sebseb7/brushless-controller/README.md

brushless-controller
====================
