sebseb7/brushless-controller/1bl.brd

## EAGLE design 1bl.brd (2013-03-14)

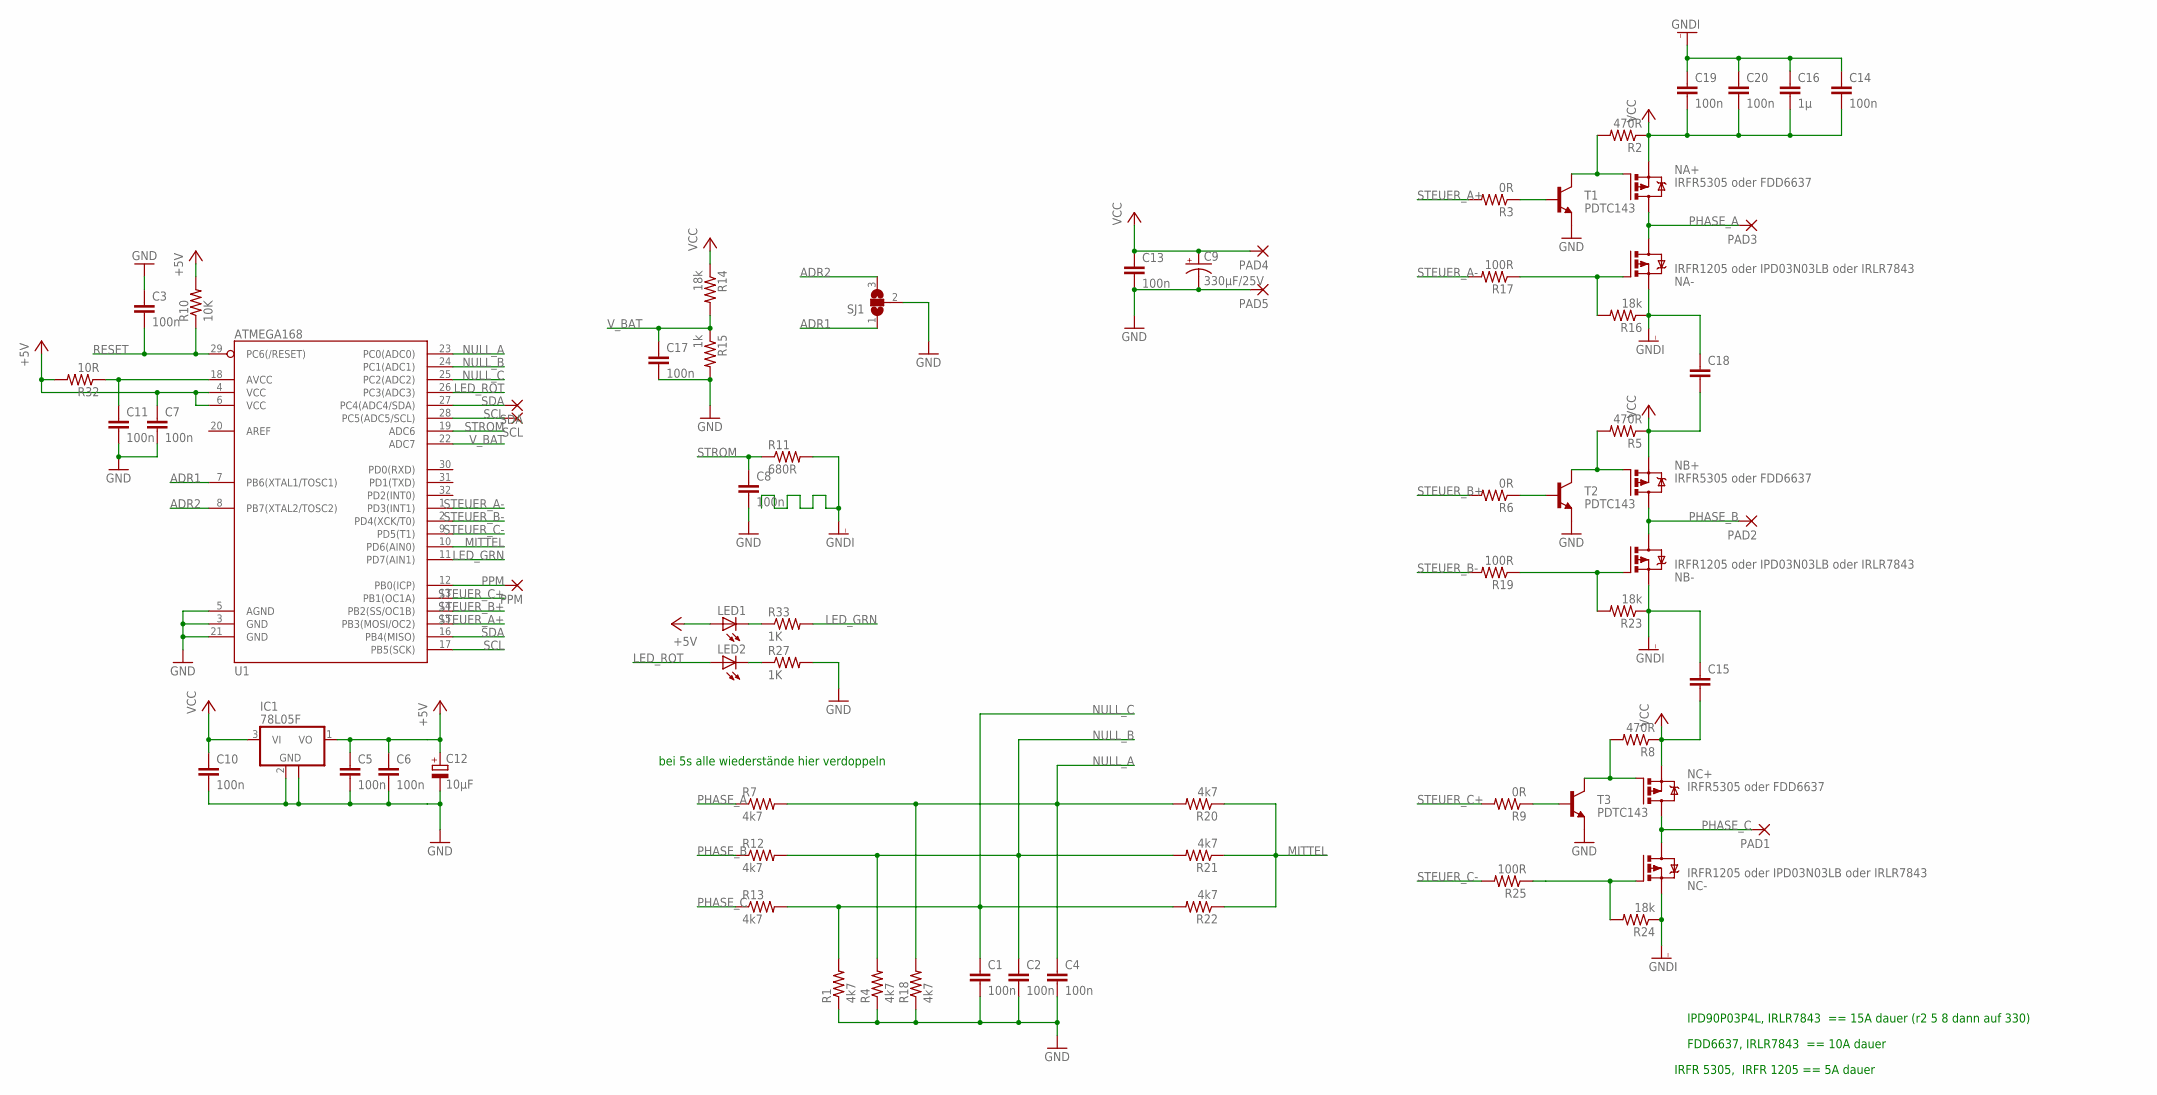
[picture p1: schematic 1bl.sch]

Parts:
C1, C2, C3, C4, C5, C6, C7, C8, C10, C11, C13, C14, C17, C19, C20: 100n; 0805
C9: 330µF/25V; CPOL-RADIAL-1000UF-25V
C12: 10µF; PANASONIC_B
C15, C18: CAP0805; 0805
C16: 1µ; 0805
IC1: 78L05F; SOT89
LED1, LED2: LEDCHIP-LED0805; CHIP-LED0805
NA+: IRFR5305 oder FDD6637; D-PAK_TO252AA
NA-: IRFR1205 oder IPD03N03LB oder IRLR7843; D-PAK_TO252AA
NB+: IRFR5305 oder FDD6637; D-PAK_TO252AA
NB-: IRFR1205 oder IPD03N03LB oder IRLR7843; D-PAK_TO252AA
NC+: IRFR5305 oder FDD6637; D-PAK_TO252AA
NC-: IRFR1205 oder IPD03N03LB oder IRLR7843; D-PAK_TO252AA
PAD1, PAD2, PAD3, PAD4, PAD5: SMD5; SMD2,54-5,08
PPM: SMD2; SMD1,27-2,54
R1, R4, R7, R12, R13, R18, R20, R21, R22: 4k7; 0805
R2, R5, R8: 470R; 0805
R3, R6, R9: 0R; 0805
R10: 10K; 0805
R11: 680R; 0805
R14, R16, R23, R24: 18k; 0805
R15: 1k; 0805
R17, R19, R25: 100R; 0805
R27, R33: 1K; 0805
R32: 10R; 0805
SCL: SMD2; SMD1,27-2,54
SDA: SMD2; SMD1,27-2,54
SJ1: SJ2W; SJ_2
T1, T2, T3: PDTC143; SOT23
U1: ATMEGA168; TQFP32-08

Connections:
+5V: C5.1, C6.1, C7.1, C12.+, IC1.1 (VO), LED1.A, R10.2, R32.2, U1.4 (VCC), U1.6 (VCC)
ADR1: SJ1.1, U1.7 (PB6(XTAL1/TOSC1))
ADR2: SJ1.3, U1.8 (PB7(XTAL2/TOSC2))
GND: C1.2, C2.2, C3.1, C4.2, C5.2, C6.2, C7.2, C8.2, C9.2 (-), C10.2, C11.2, C12.-, C13.2, C17.2, IC1.2 (GND), IC1.2@1 (GND), PAD5.1, R1.1, R4.1, R15.2, R18.1, R27.2, SJ1.2, T1.2 (E), T2.2 (E), T3.2 (E), U1.3 (GND), U1.5 (AGND), U1.21 (GND)
GNDI: C14.1, C15.1, C16.1, C18.1, C19.1, C20.1, NA-.3 (S), NB-.3 (S), NC-.3 (S), R11.2, R16.1, R23.1, R24.1
LED_GRN: R33.2, U1.11 (PD7(AIN1))
LED_ROT: LED2.A, U1.26 (PC3(ADC3))
MITTEL: R20.1, R21.1, R22.1, U1.10 (PD6(AIN0))
unnamed: C11.1, R32.1, U1.18 (AVCC)
unnamed: NC+.1 (G), R8.2, T3.3 (C)
unnamed: NB+.1 (G), R5.2, T2.3 (C)
unnamed: NA+.1 (G), R2.2, T1.3 (C)
unnamed: LED1.C, R33.1
unnamed: LED2.C, R27.1
unnamed: NA-.1 (G), R16.2, R17.1
unnamed: NB-.1 (G), R19.1, R23.2
unnamed: NC-.1 (G), R24.2, R25.1
unnamed: R3.1, T1.1 (B)
unnamed: R6.1, T2.1 (B)
unnamed: R9.1, T3.1 (B)
NULL_A: C4.1, R7.2, R18.2, R20.2, U1.23 (PC0(ADC0))
NULL_B: C2.1, R4.2, R12.2, R21.2, U1.24 (PC1(ADC1))
NULL_C: C1.1, R1.2, R13.2, R22.2, U1.25 (PC2(ADC2))
PHASE_A: NA+.4 (D), NA-.4 (D), PAD3.1, R7.1
PHASE_B: NB+.4 (D), NB-.4 (D), PAD2.1, R12.1
PHASE_C: NC+.4 (D), NC-.4 (D), PAD1.1, R13.1
PPM: PPM.1, U1.12 (PB0(ICP))
RESET: C3.2, R10.1, U1.29 (PC6(/RESET))
SCL: SCL.1, U1.17 (PB5(SCK)), U1.28 (PC5(ADC5/SCL))
SDA: SDA.1, U1.16 (PB4(MISO)), U1.27 (PC4(ADC4/SDA))
STEUER_A+: R3.2, U1.15 (PB3(MOSI/OC2))
STEUER_A-: R17.2, U1.1 (PD3(INT1))
STEUER_B+: R6.2, U1.14 (PB2(SS/OC1B))
STEUER_B-: R19.2, U1.2 (PD4(XCK/T0))
STEUER_C+: R9.2, U1.13 (PB1(OC1A))
STEUER_C-: R25.2, U1.9 (PD5(T1))
STROM: C8.1, R11.1, U1.19 (ADC6)
VCC: C9.1 (+), C10.1, C13.1, C14.2, C15.2, C16.2, C18.2, C19.2, C20.2, IC1.3 (VI), NA+.3 (S), NB+.3 (S), NC+.3 (S), PAD4.1, R2.1, R5.1, R8.1, R14.1
V_BAT: C17.1, R14.2, R15.1, U1.22 (ADC7)

Notes on the sheet:
FDD6637, IRLR7843 == 10A dauer
IRFR 5305, IRFR 1205 == 5A dauer
IPD90P03P4L, IRLR7843 == 15A dauer (r2 5 8 dann auf 330)
bei 5s alle wiederstände hier verdoppeln

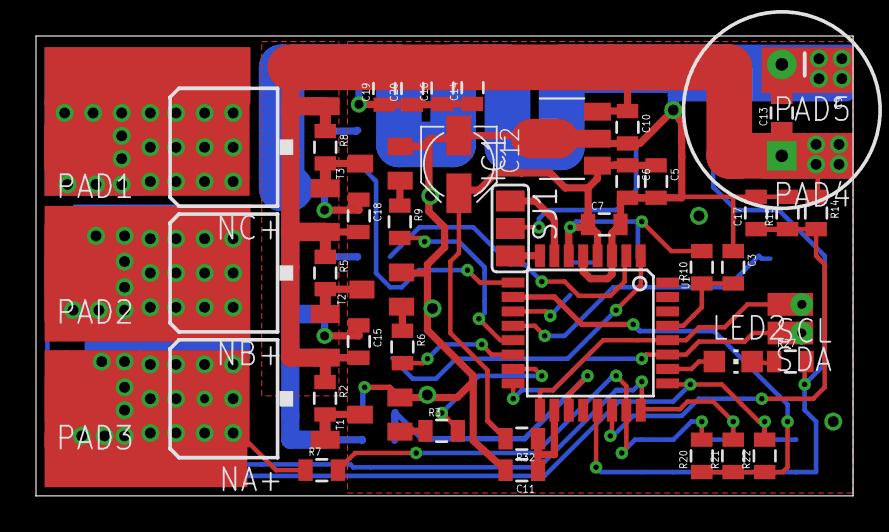
[picture p2: board 1bl.brd from above]

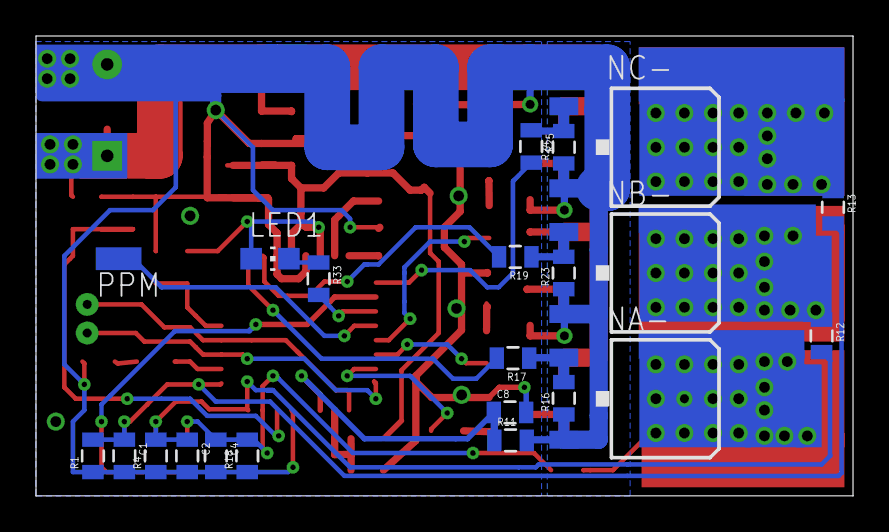
[picture p3: board 1bl.brd from below]

Board: 2 copper layers, 45.4 x 25.5 mm, 70 parts (22 on the bottom side), 39 nets.
